lennart-goetz/Low-Noise-Amp-1296MHz/mechanik/Bias_T.png

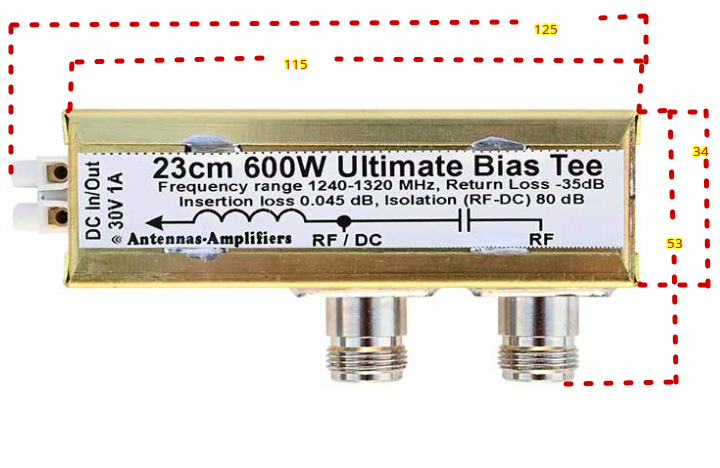
mechanik/Bias_T.png
