lennart-goetz/Low-Noise-Amp-1296MHz/part_files_pcb/LIB_SKY67151-396LF/SKY67151-396LF/3D/SKY67151-396LF.stp

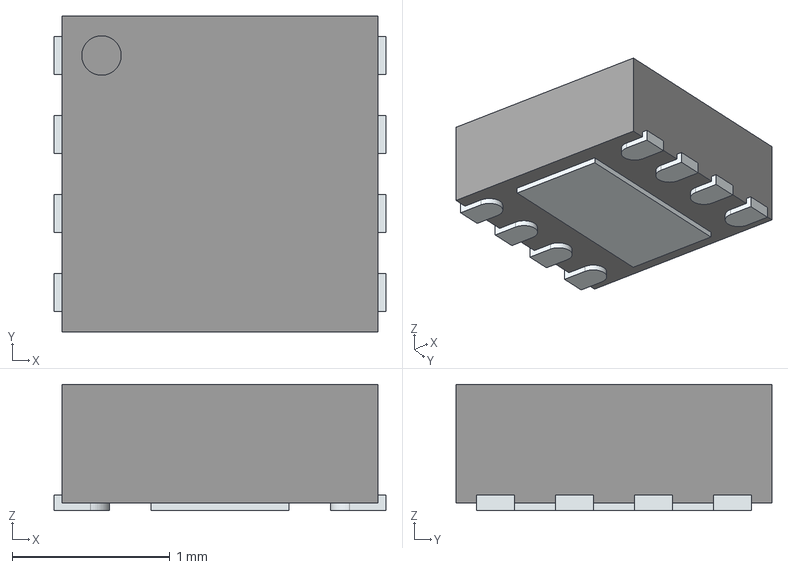
[picture p16: CAD file, 2026-03-16, last stored version]
part_files_pcb/LIB_SKY67151-396LF/SKY67151-396LF/3D/SKY67151-396LF.stp
2.10 x 2.00 x 0.8 mm
ThermalPin
PinsArrayLR
