lennart-goetz/Low-Noise-Amp-1296MHz/(list of files, cad)

Other CAD files:
part_files_pcb/LIB_SKY67151-396LF/SKY67151-396LF/Allegro/son50p200x200x80-9n-d.psm
part_files_pcb/LIB_SKY67151-396LF/SKY67151-396LF/DEHDL/sky67151_396lf/chips/chips.prt
