lennart-goetz/Low-Noise-Amp-1296MHz/schematic.pdf

0402 ¹ ²

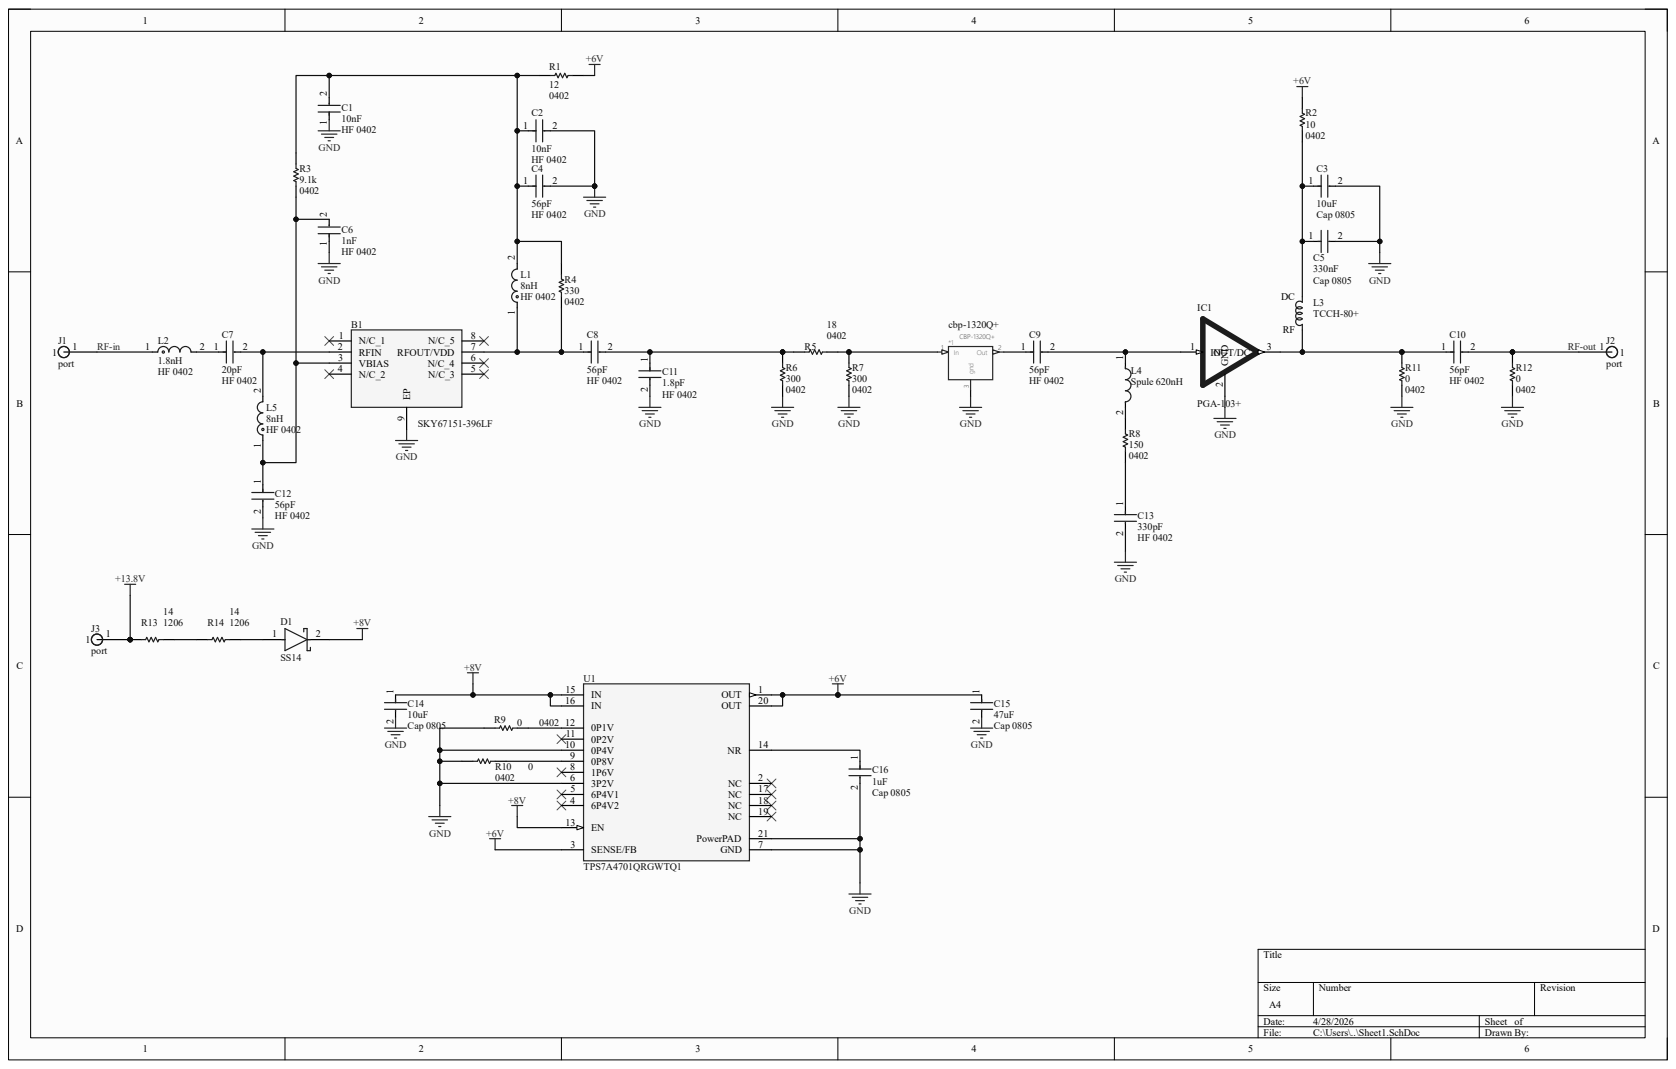
[picture p17: page 1]
