lennart-goetz/Low-Noise-Amp-1296MHz/Auswahl_Komponenten/020368_Datenblatt_J01020B0081KP.pdf

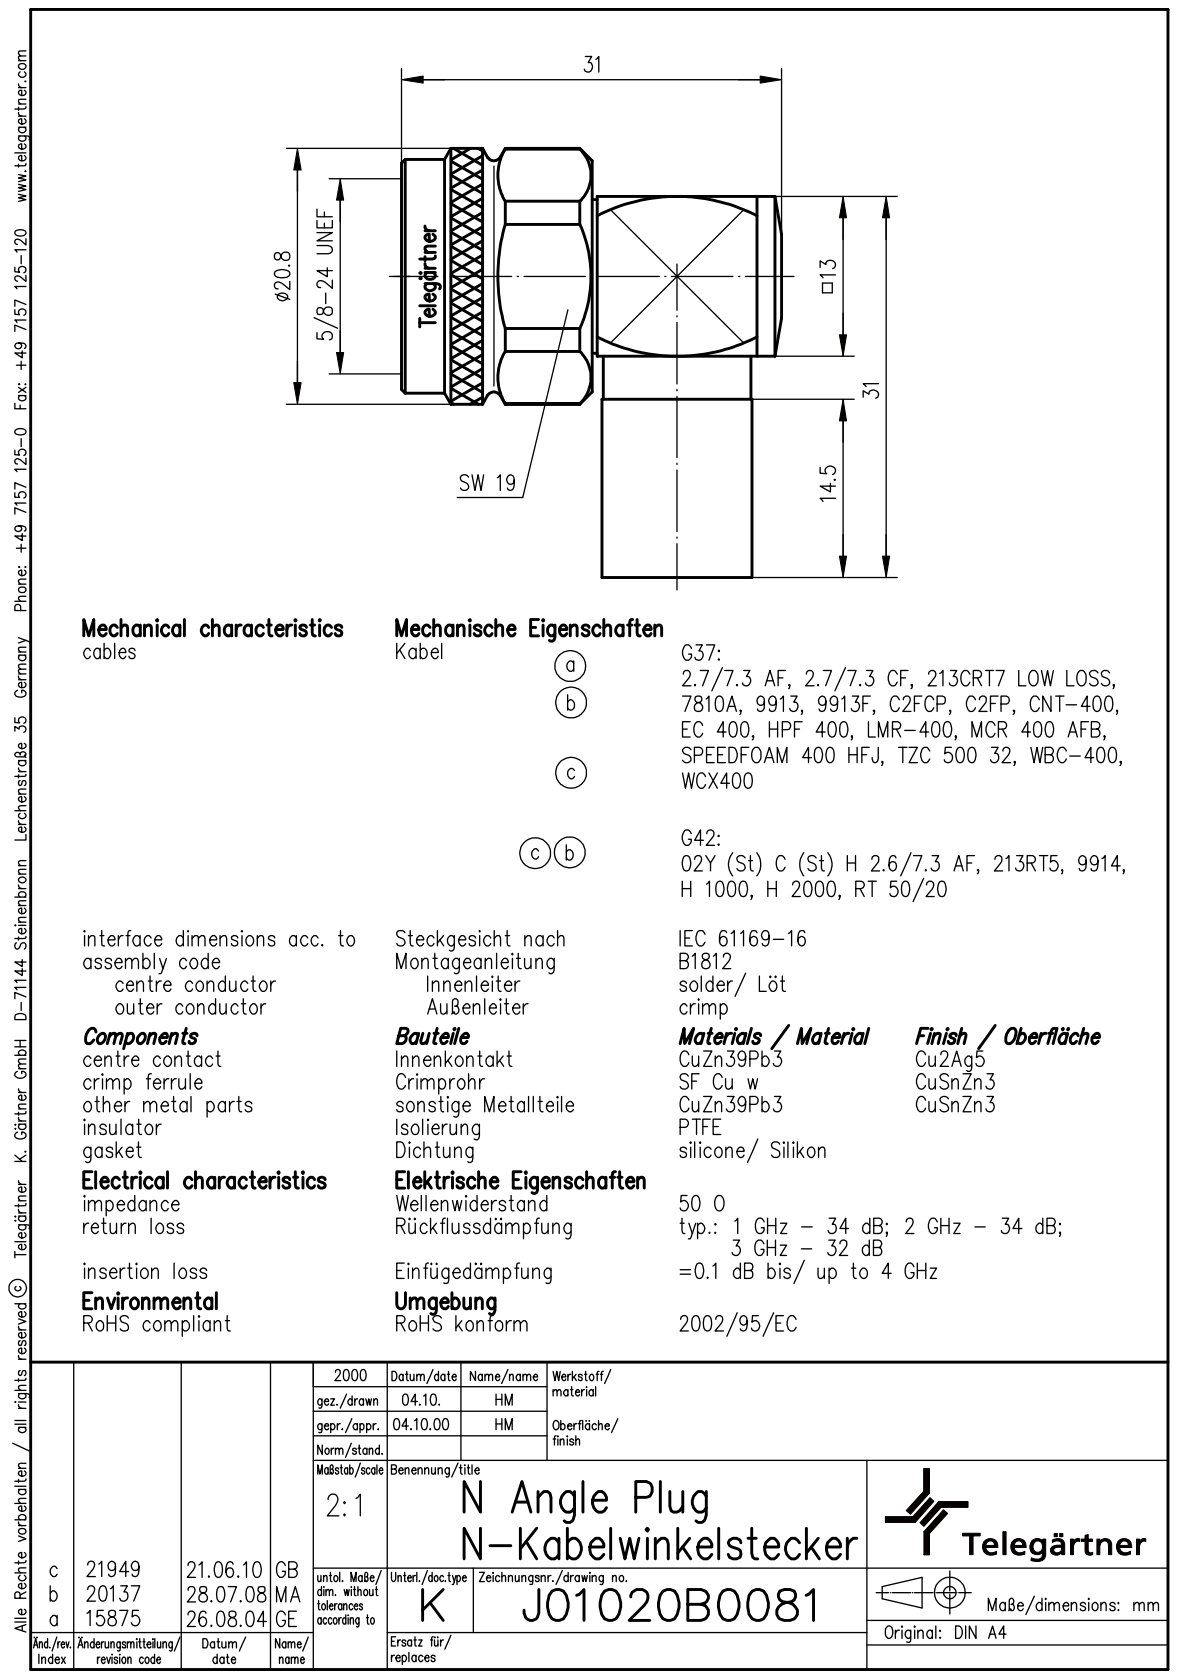
[picture p18: page 1]
