lennart-goetz/Low-Noise-Amp-1296MHz/mechanik/machanik_Skizze.pdf

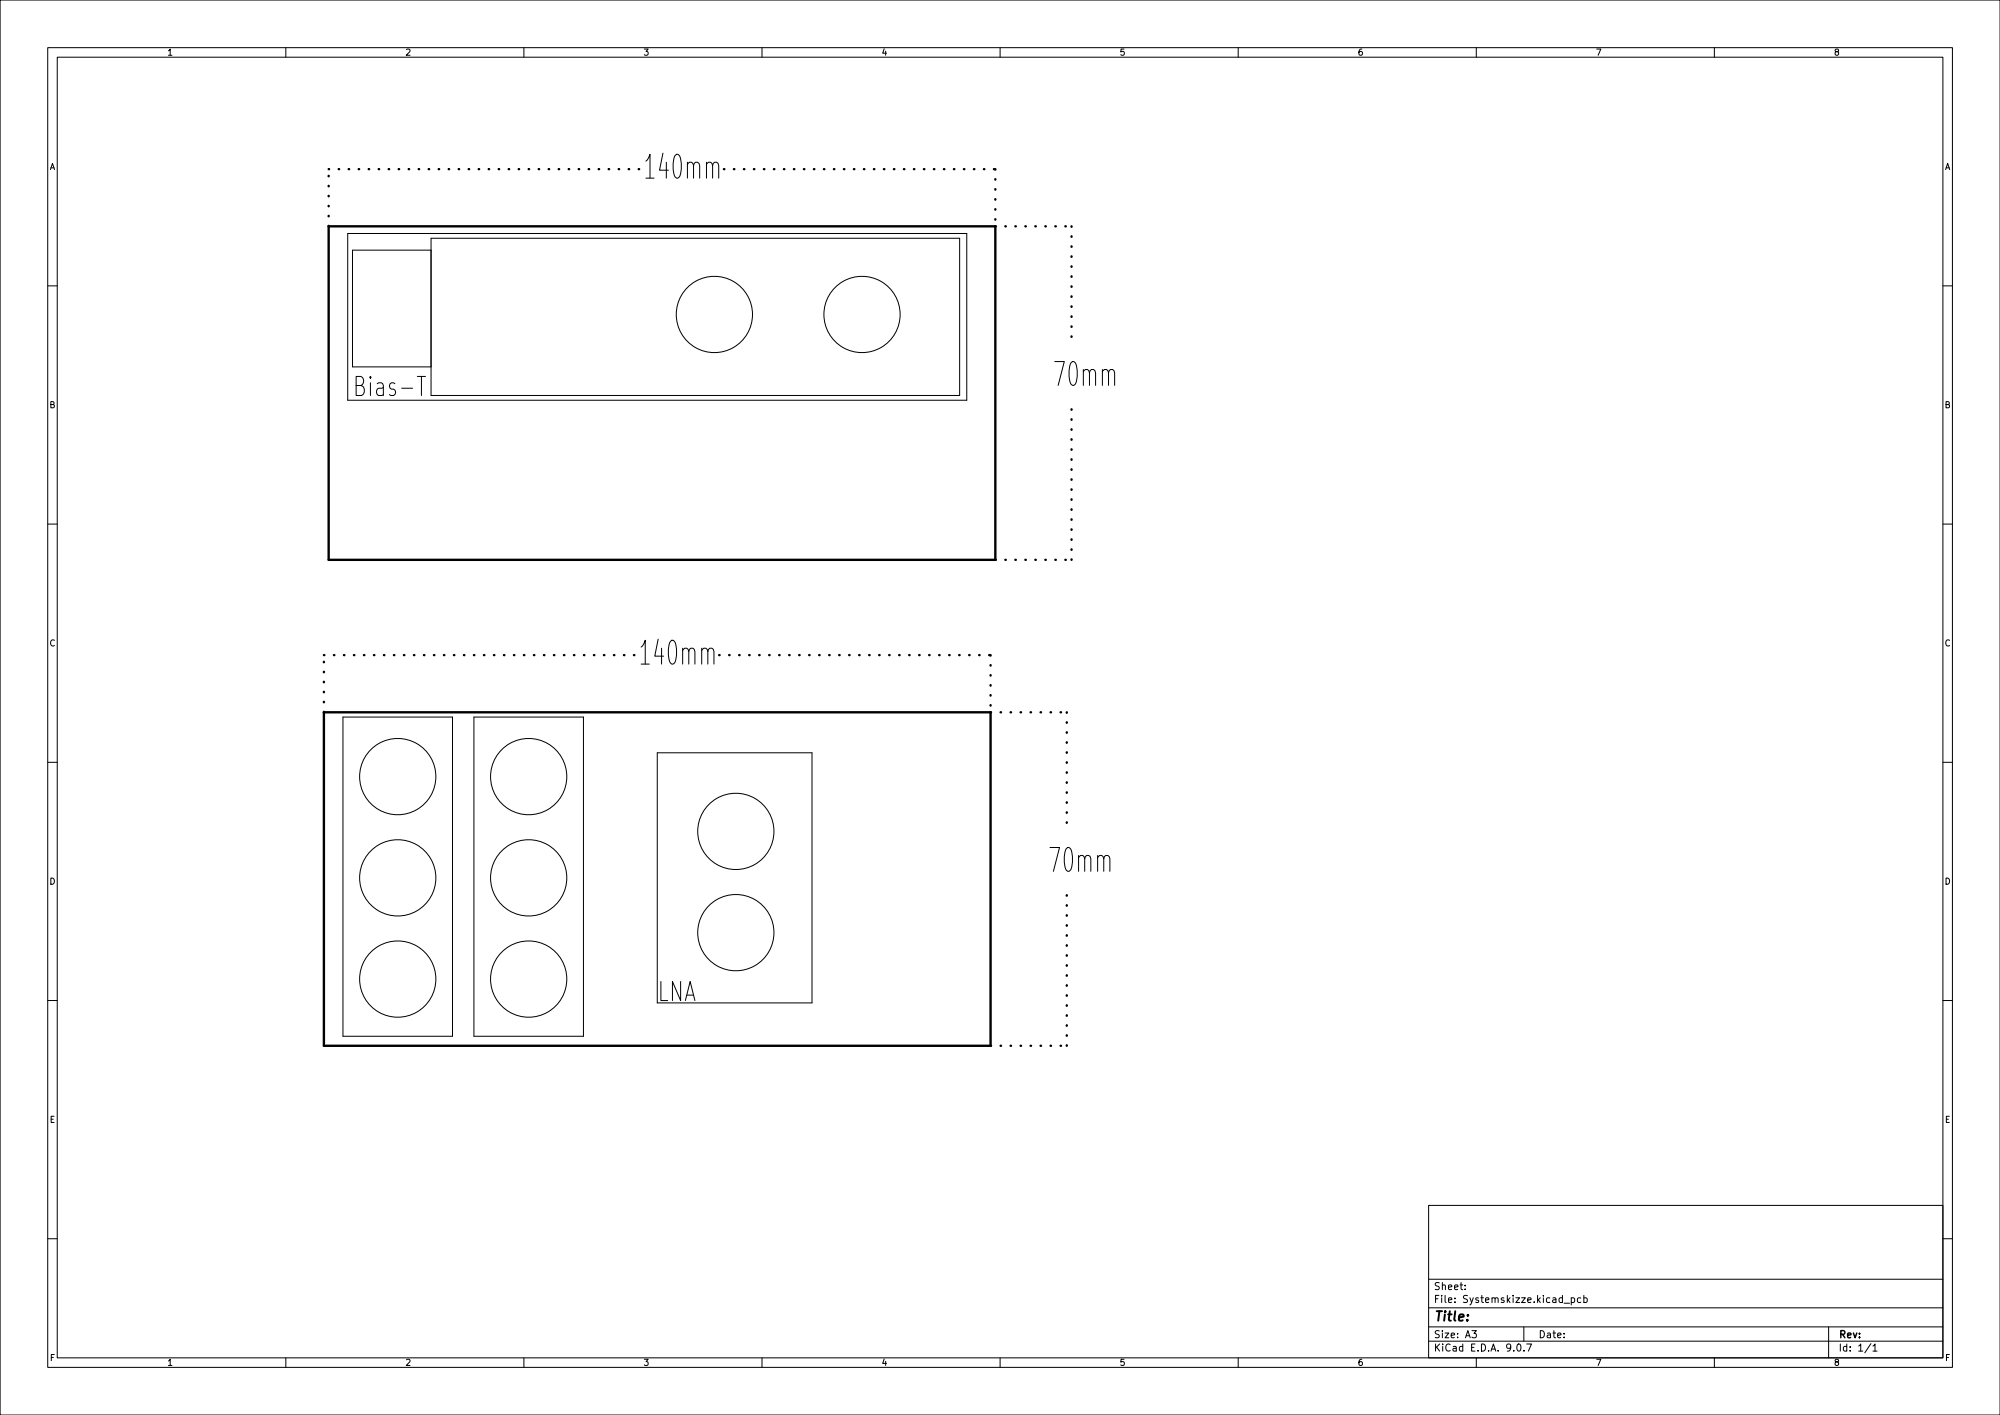
[picture p19: page 1]
