lennart-goetz/Low-Noise-Amp-1296MHz/mechanik/Mechanik_Skizze.pdf

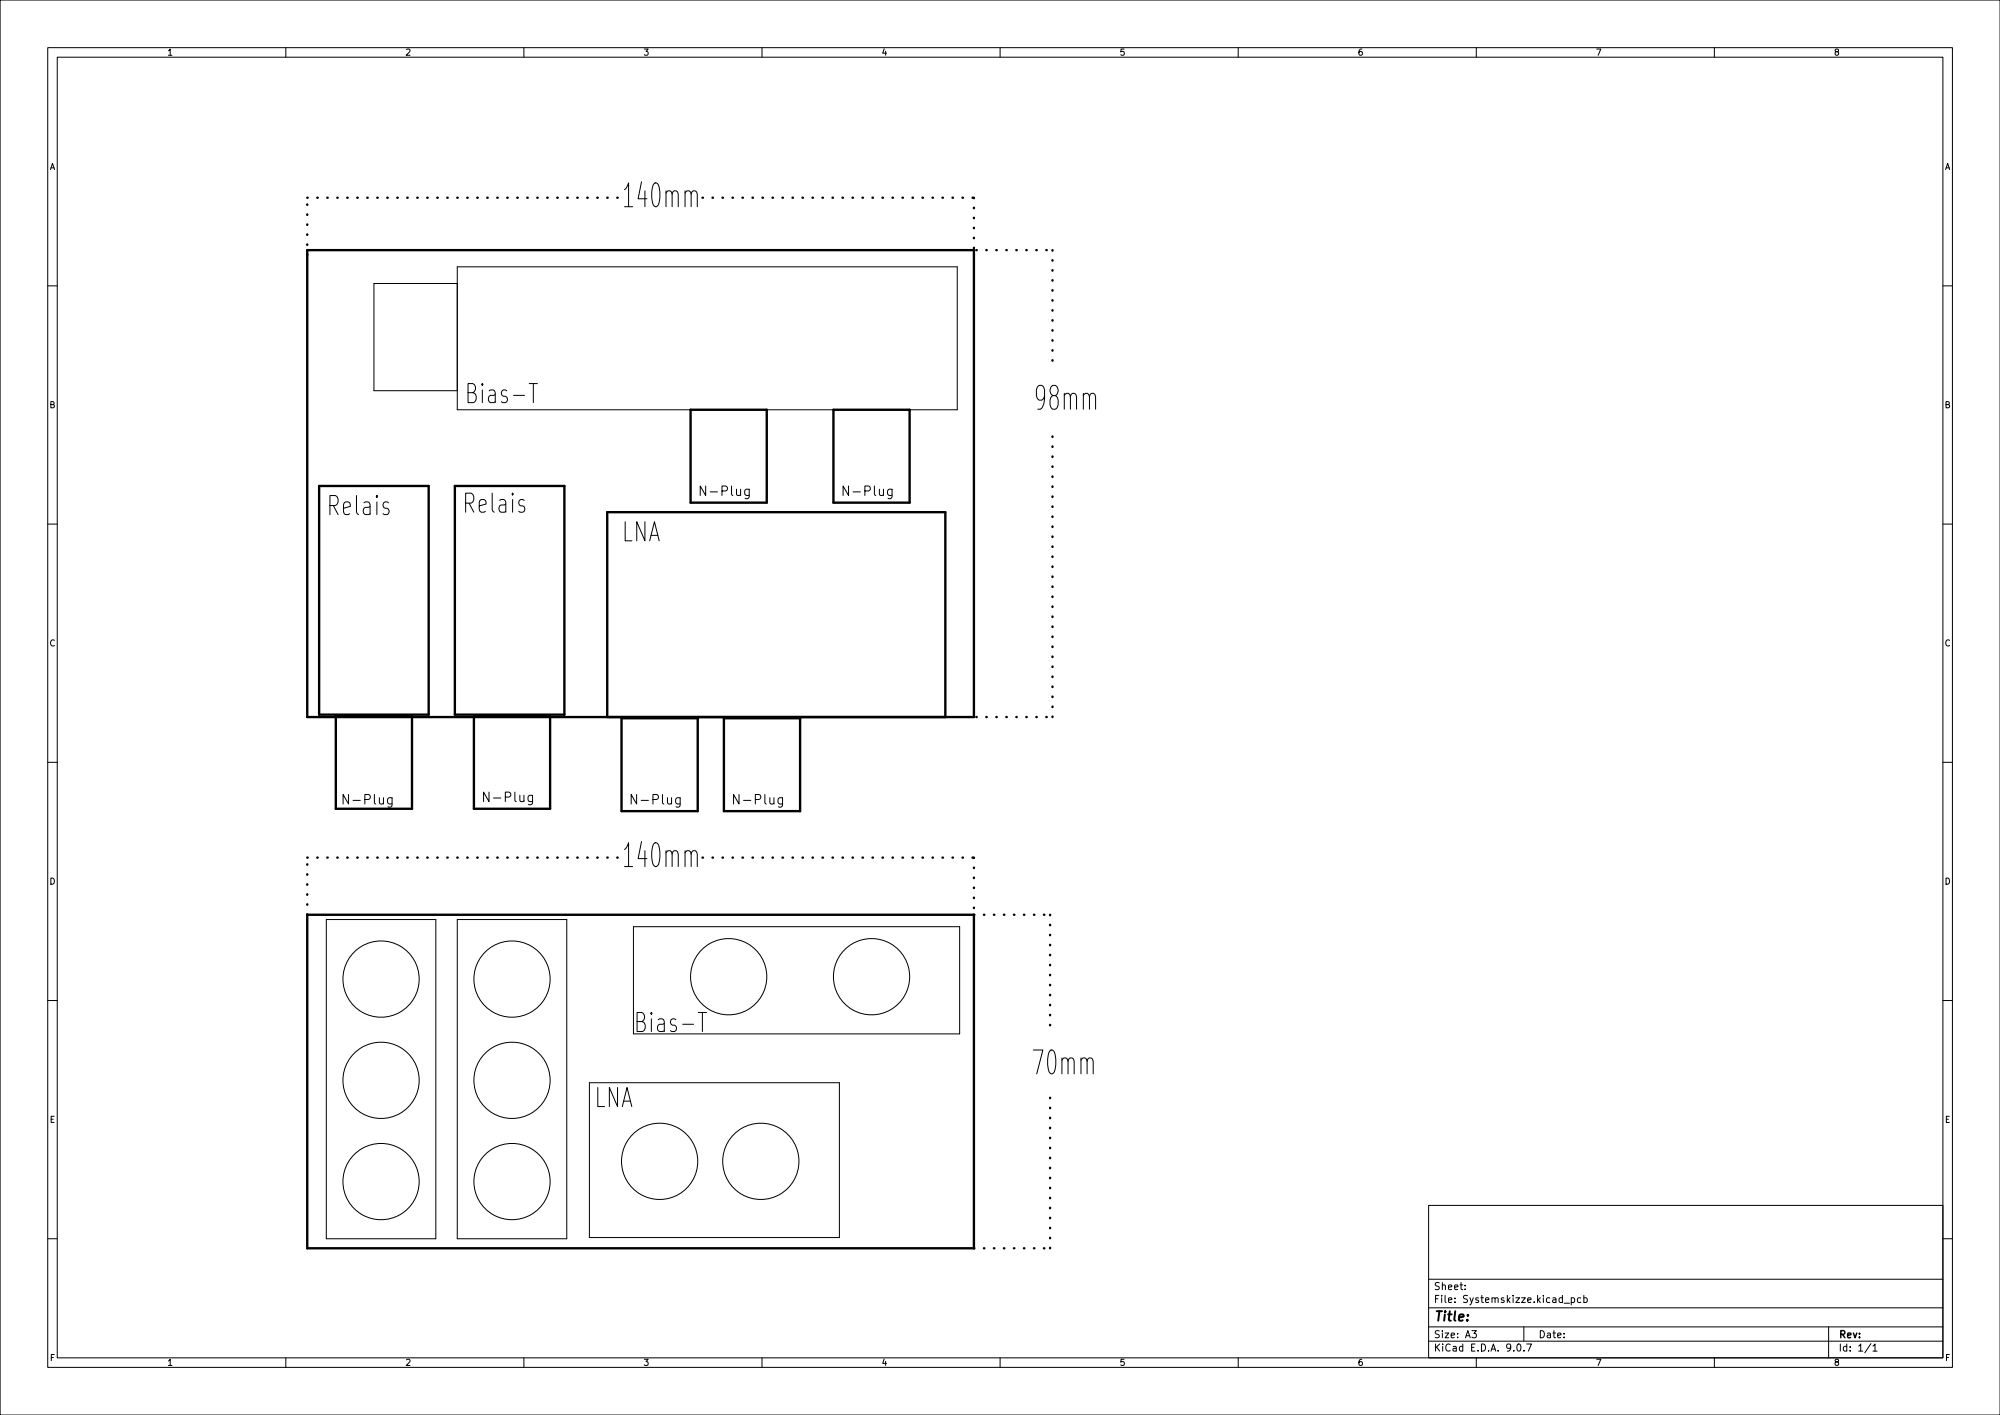
[picture p20: page 1]
