lennart-goetz/Low-Noise-Amp-1296MHz/(list of files, drawings)

Other design files:
part_files_pcb/LIB_SKY67151-396LF/SKY67151-396LF/Altium/SKY67151-396LF.SchLib
part_files_pcb/LIB_SKY67151-396LF/SKY67151-396LF/Altium/SON50P200X200X80-9N-D.PcbLib
uSimmics/templates/two_port_sim.pcb
