lennart-goetz/Low-Noise-Amp-1296MHz/kicad_lna_design/kicad_lna_design.kicad_pcb

## KiCad design kicad_lna_design/kicad_lna_design.kicad_pcb (2026-03-16, last stored version)

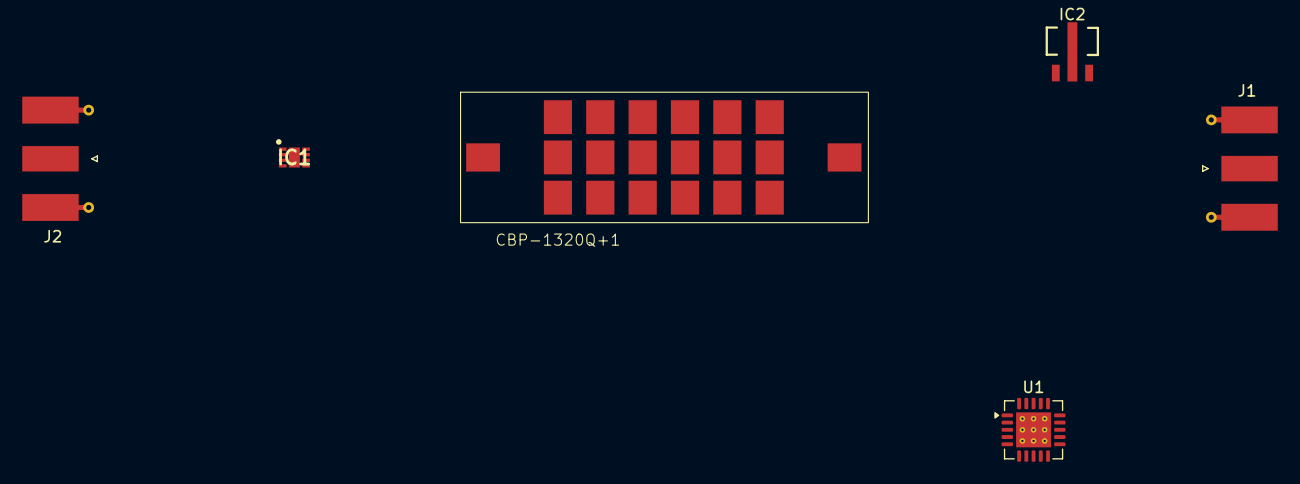
[picture p21: board kicad_lna_design.kicad_pcb from above]

Board: 2 copper layers, 6 parts (0 on the bottom side), 5 nets, no tracks yet.

Parts:
CBP-1320Q+1: cbp-1320Q+
IC1: SKY67151-396LF
IC2: pga-103+
J1, J2: Conn_Coaxial; SMA_Molex_73251-1153_EdgeMount_Horizontal
U1: TPS7A4701xRGW; Texas_RGW0020A_VQFN-20-1EP_5x5mm_P0.65mm_EP3.15x3.15mm_Ther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

Connections:
GND: CBP-1320Q+1.3 (gnd), IC2.2 (GND), J1.2 (Ext), J2.2 (Ext)
unnamed: CBP-1320Q+1.2 (Out), IC2.1 (IN)
unnamed: IC2.3 (OUT/DC), J2.1 (In)
unnamed: U1.15 (IN), U1.16 (IN)
unnamed: U1.1 (OUT), U1.20 (OUT)
