lennart-goetz/Low-Noise-Amp-1296MHz/(commit log)

2026-03-17 updated mechanical planning
    [Systemskizze.kicad_pcb]
2026-03-24 updates schematic and pcb Design
2026-03-26 added production data for pcb
2026-03-26 added production files for PCB
    [BJT_charac.sch, BJT_gummel_plot.sch, BJT_transit_freq.sch, EDI2CAP.CFG, FET_charac.sch, FET_maxFreq.sch, SKY67151-396LF.SchLib, SKY67151-396LF.stp]
2026-04-23 LNA V1 assembled photos
2026-04-23 added gerber files
2026-04-28 added schematic
